luckysunz/sportstracker_plus/gehaeuse/Pictogramme/RocknRoll.webp

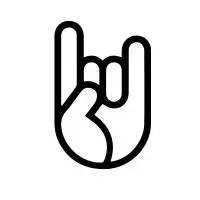
gehaeuse/Pictogramme/RocknRoll.webp
