luckysunz/sportstracker_plus/gehaeuse/Pictogramme/toilet.webp

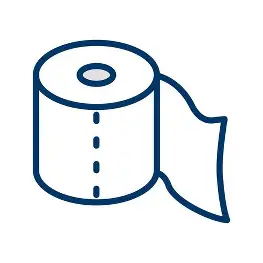
gehaeuse/Pictogramme/toilet.webp
