luckysunz/sportstracker_plus/gehaeuse/uebersicht.png

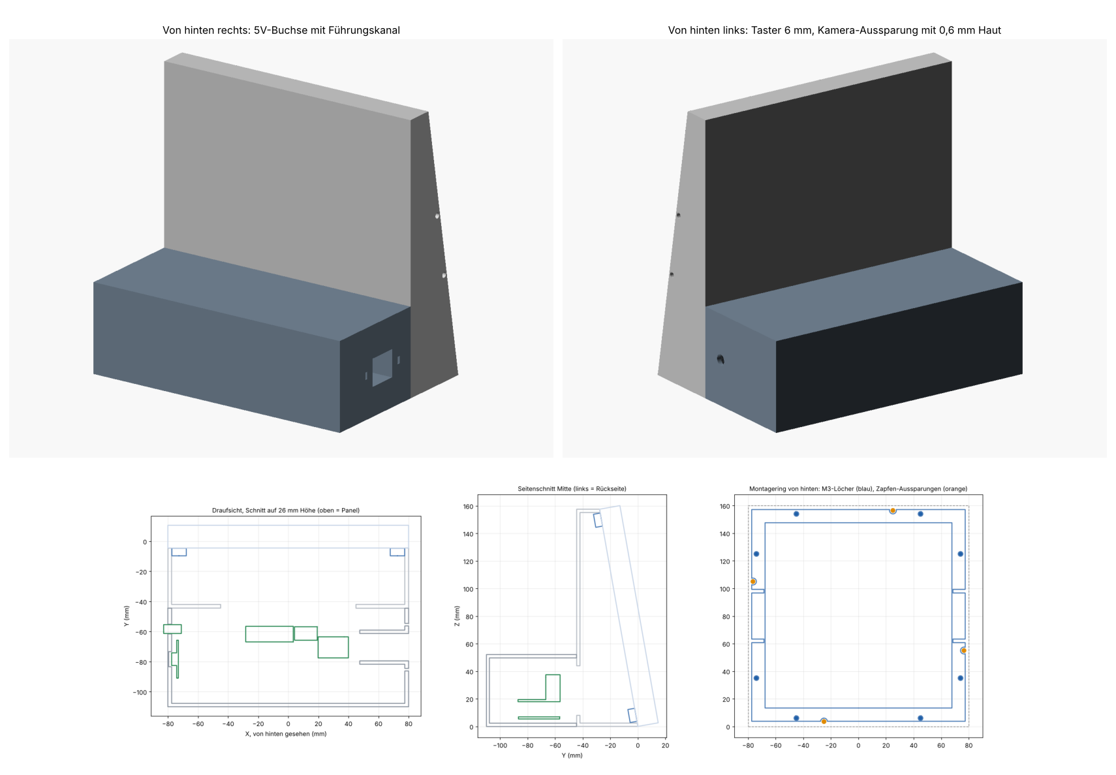
gehaeuse/uebersicht.png
