luckysunz/sportstracker_plus/gehaeuse/v2/uebersicht_v2.png

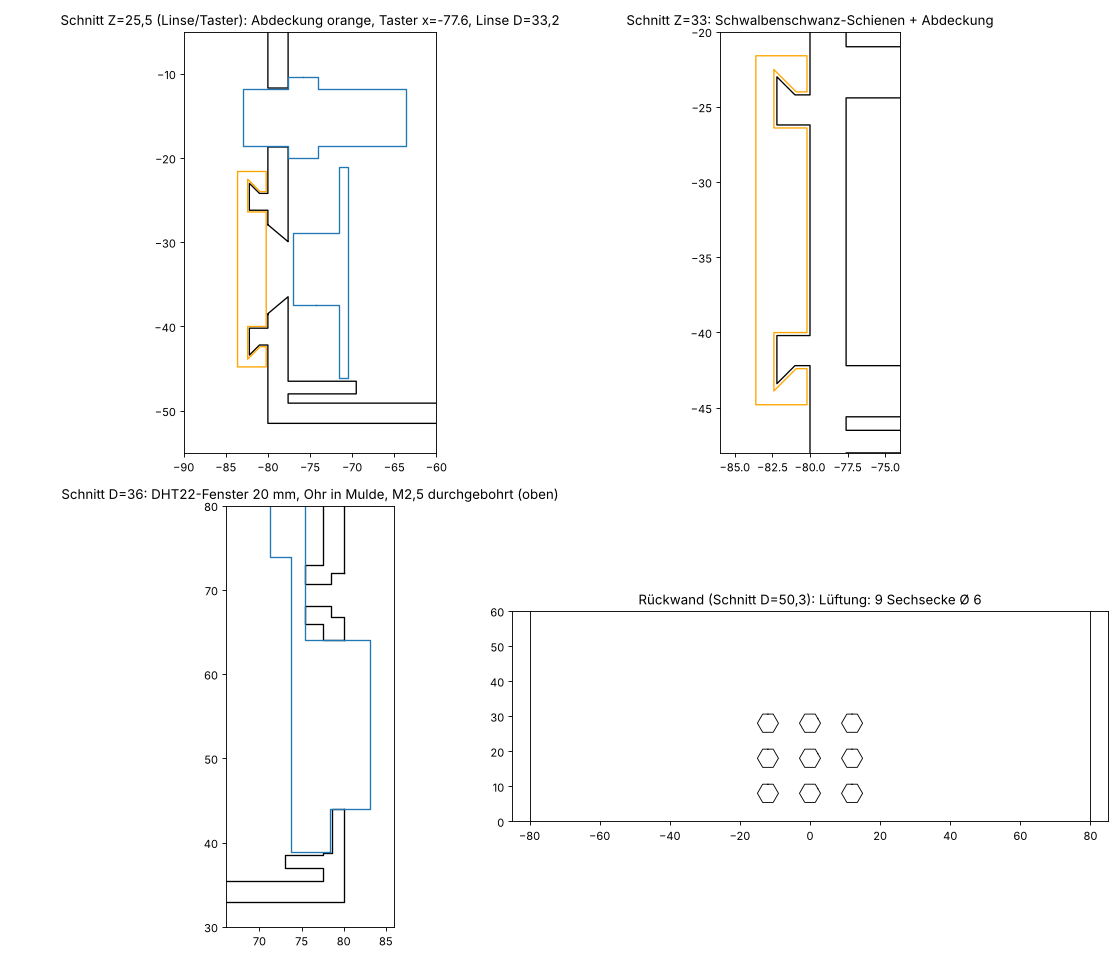
gehaeuse/v2/uebersicht_v2.png
