luckysunz/sportstracker_plus/sportstracker/demo.png

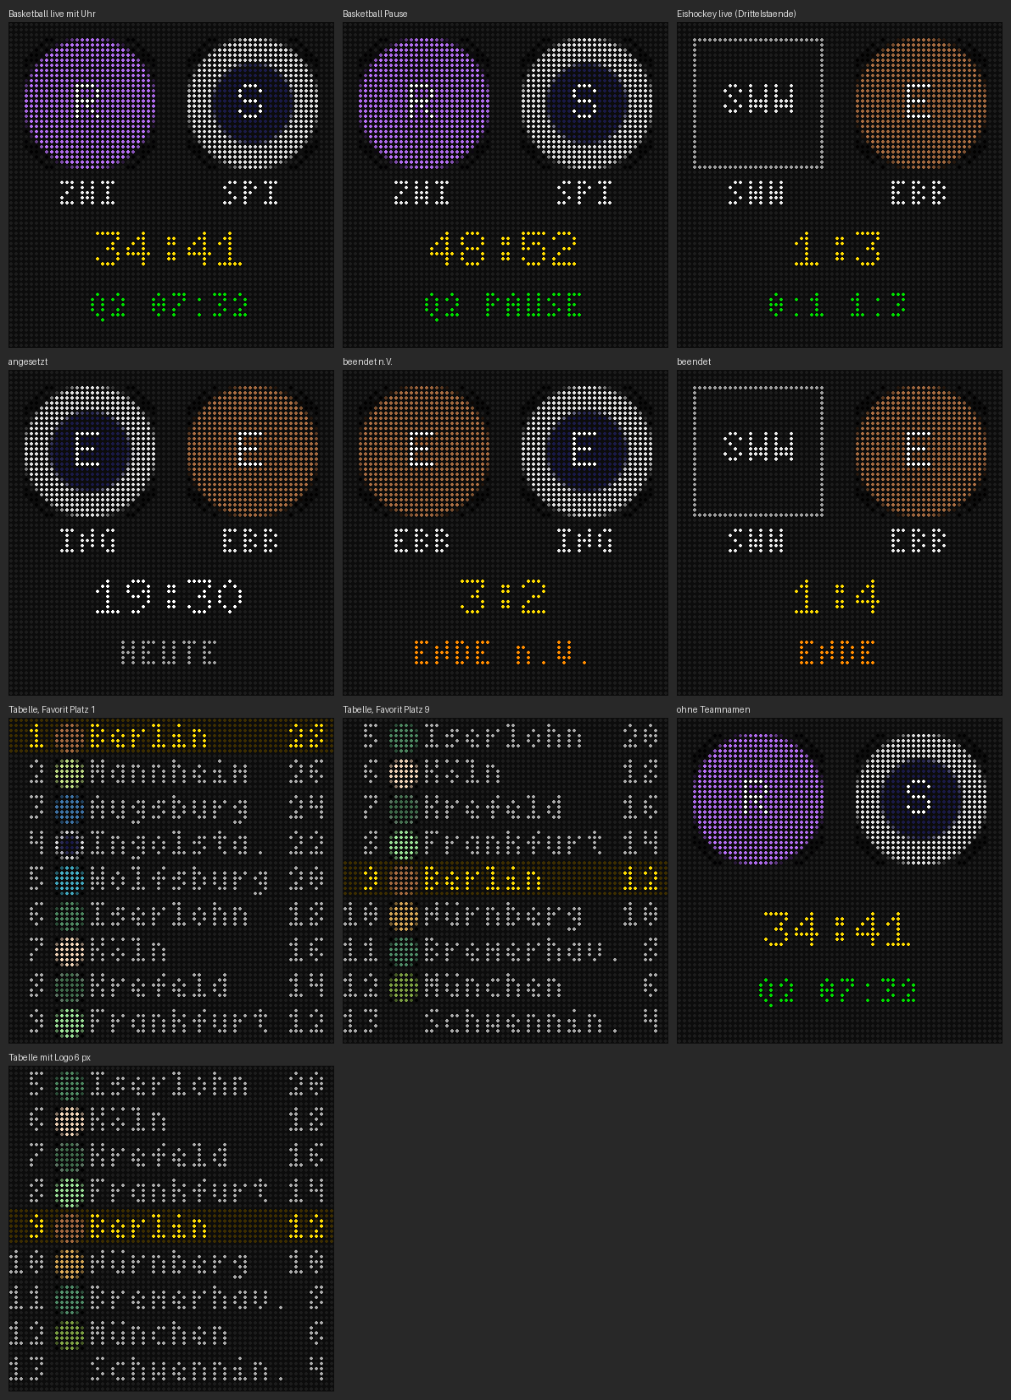
sportstracker/demo.png
