luckysunz/sportstracker_plus/sportstracker/demo_preview.png

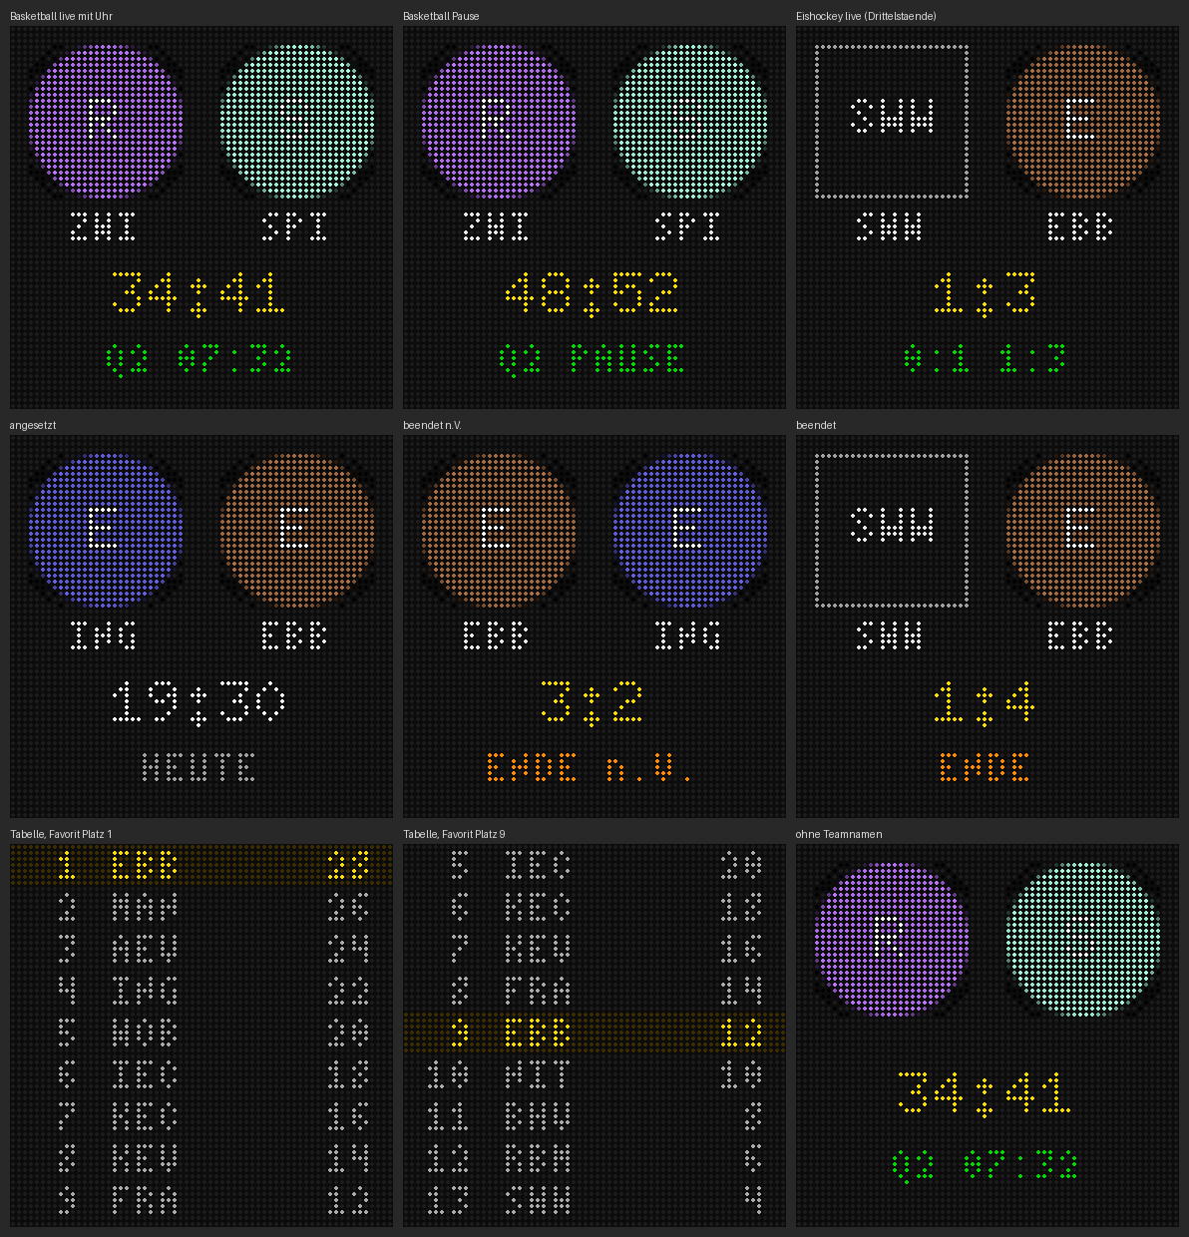
sportstracker/demo_preview.png
