luckysunz/sportstracker_plus/sportstracker/vorschau-0.7.0-designs.png

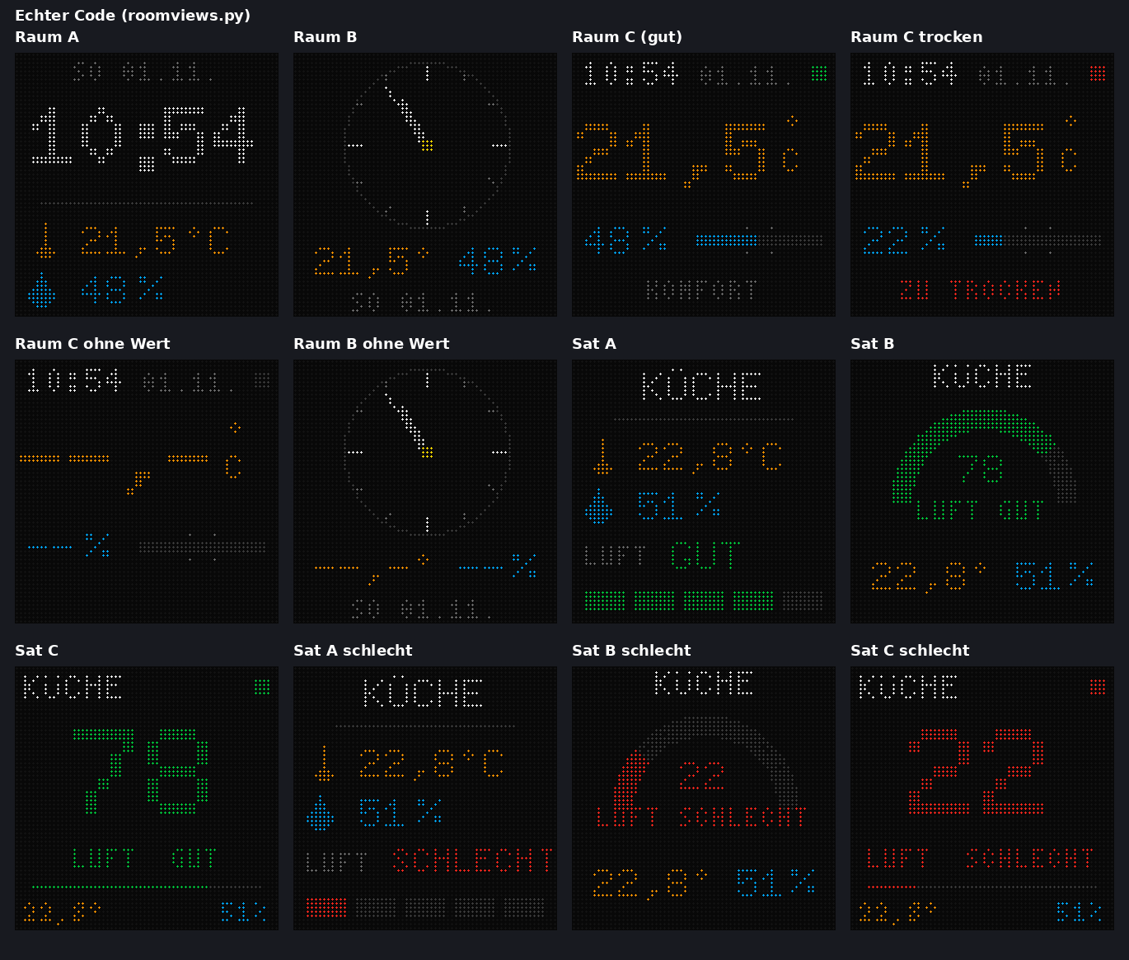
sportstracker/vorschau-0.7.0-designs.png
