luckysunz/sportstracker_plus/sportstracker/vorschau-bild-0.5.5.png

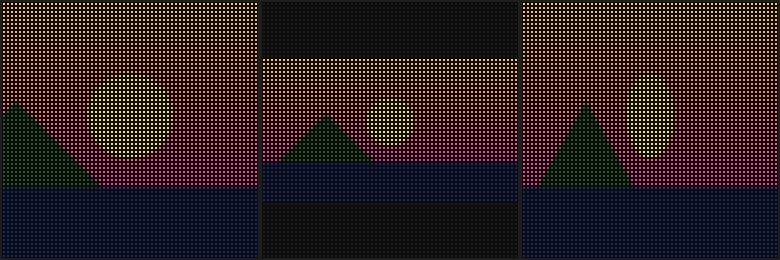
sportstracker/vorschau-bild-0.5.5.png
