luckysunz/sportstracker_plus/sportstracker/vorschau-nachricht-0.5.3.png

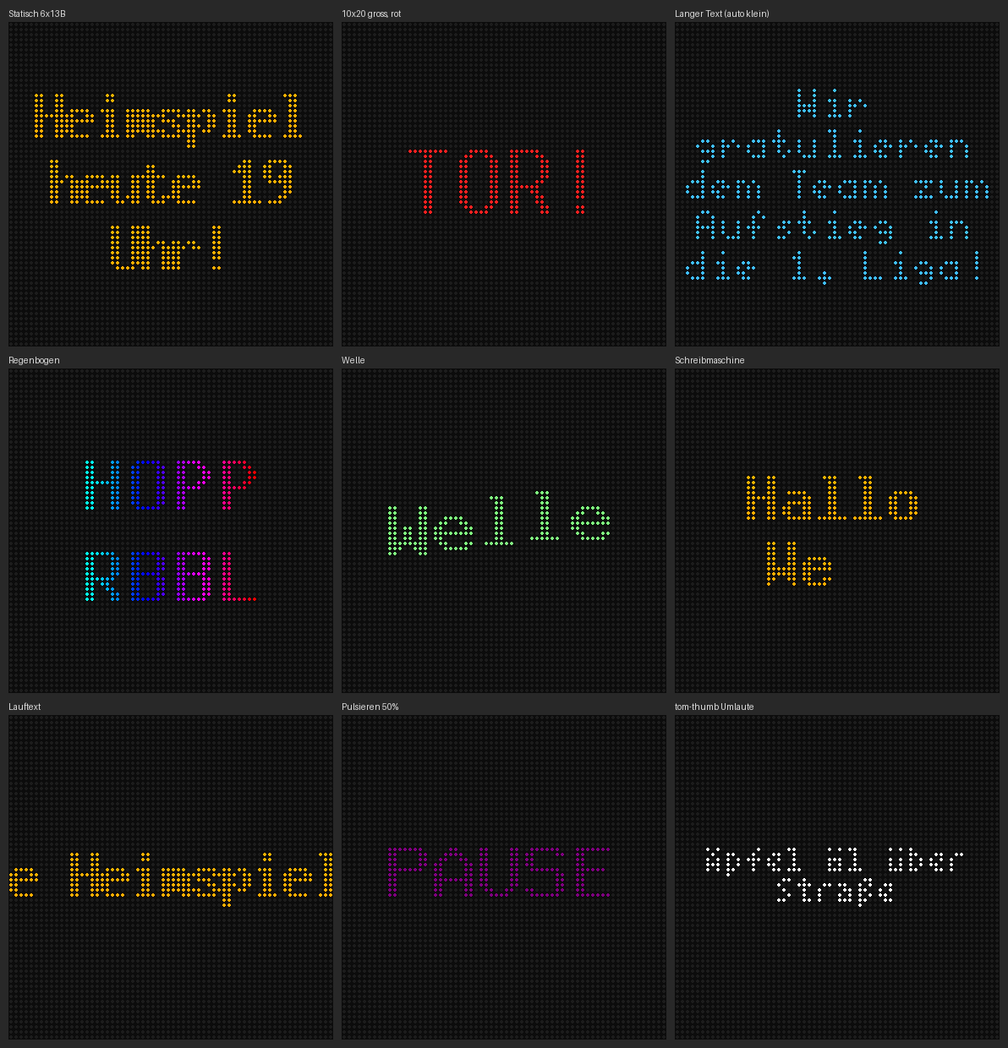
sportstracker/vorschau-nachricht-0.5.3.png
