luckysunz/sportstracker_plus/sportstracker/vorschau-raumansicht-0.5.0.png

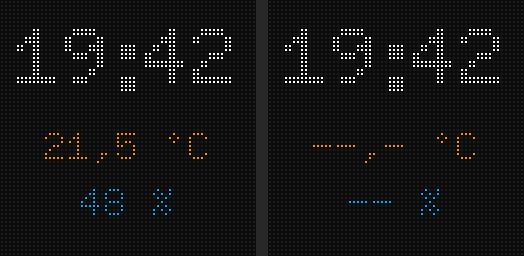
sportstracker/vorschau-raumansicht-0.5.0.png
