luckysunz/sportstracker_plus/gehaeuse/01_montagering.stl

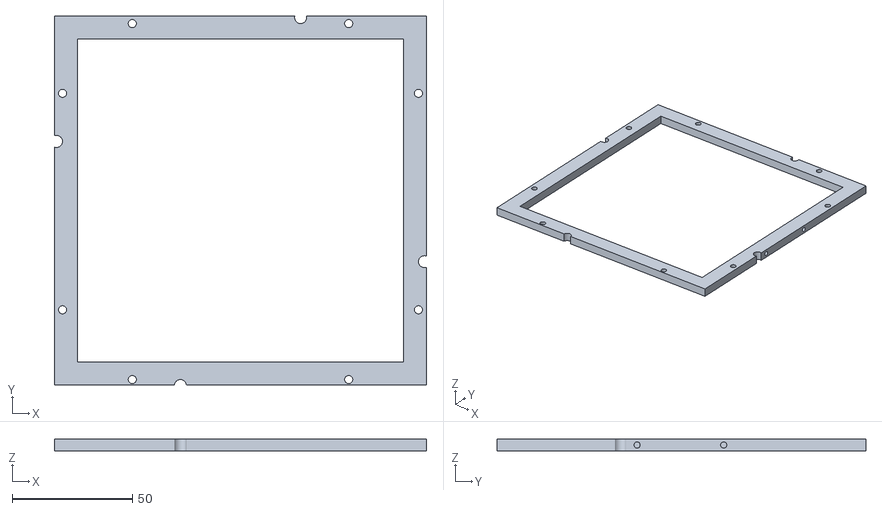
[picture p11: CAD file, 2026-11-01]
gehaeuse/01_montagering.stl
154.8 x 153.4 x 5.00
