luckysunz/sportstracker_plus/gehaeuse/Pictogramme/STL/beerpic.stl

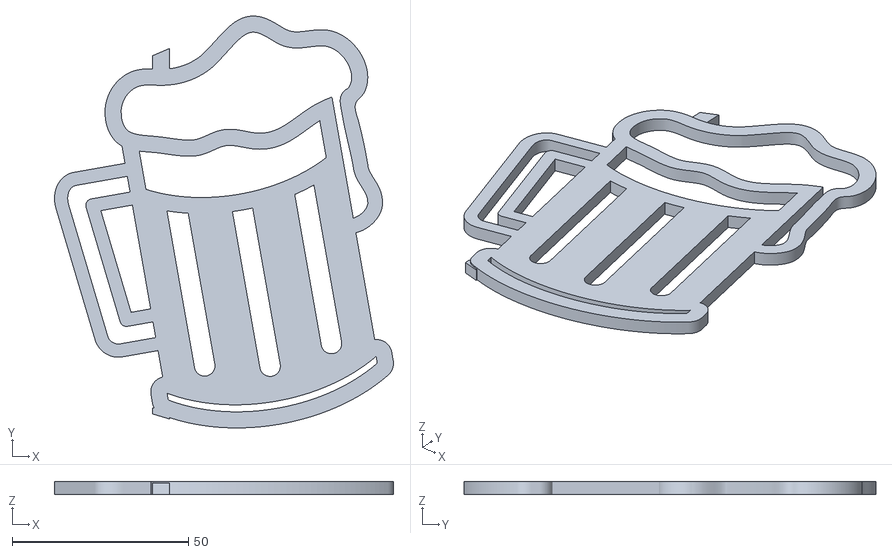
[picture p12: CAD file, 2026-11-01]
gehaeuse/Pictogramme/STL/beerpic.stl
96.3 x 117.0 x 3.60
