luckysunz/sportstracker_plus/gehaeuse/v2/05_kamera_abdeckung.stl

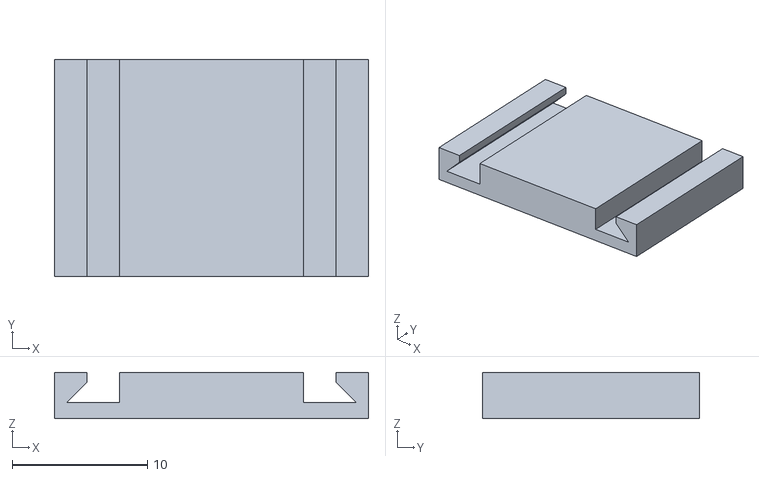
[picture p13: CAD file, 2026-11-01]
gehaeuse/v2/05_kamera_abdeckung.stl
23.2 x 16.0 x 3.40
