luckysunz/sportstracker_plus/gehaeuse/02_keilgehaeuse.stl

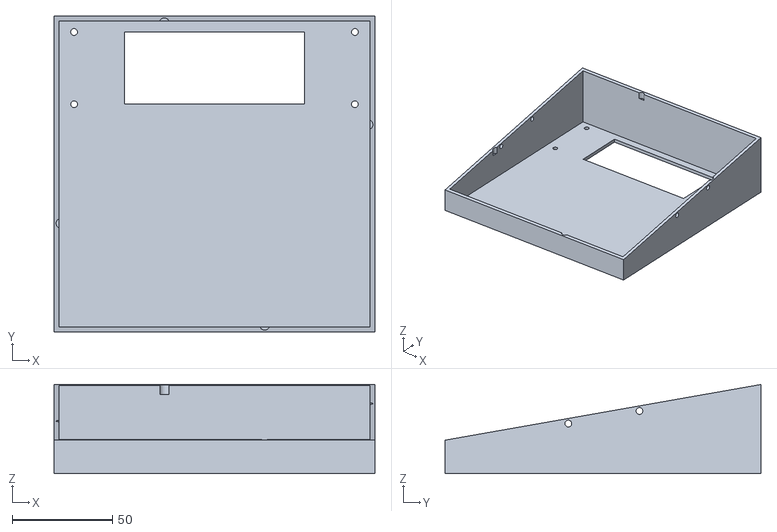
[picture p14: CAD file, 2026-11-01]
gehaeuse/02_keilgehaeuse.stl
160.0 x 157.6 x 44.4
