luckysunz/sportstracker_plus/gehaeuse/Pictogramme/STL/ImageToStl.com_toilet.stl

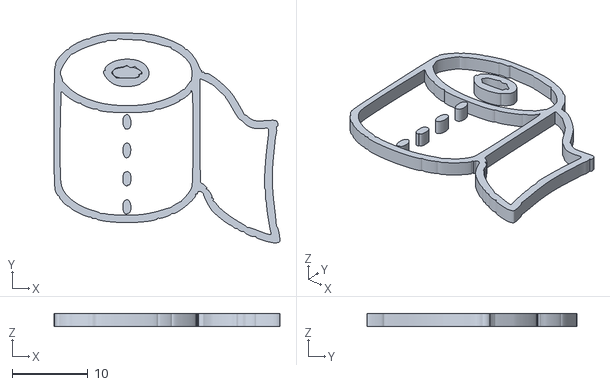
[picture p15: CAD file, 2026-11-01]
gehaeuse/Pictogramme/STL/ImageToStl.com_toilet.stl
29.9 x 27.8 x 1.65
