luckysunz/sportstracker_plus/gehaeuse/v2/03_kamera_taster_probestueck.stl

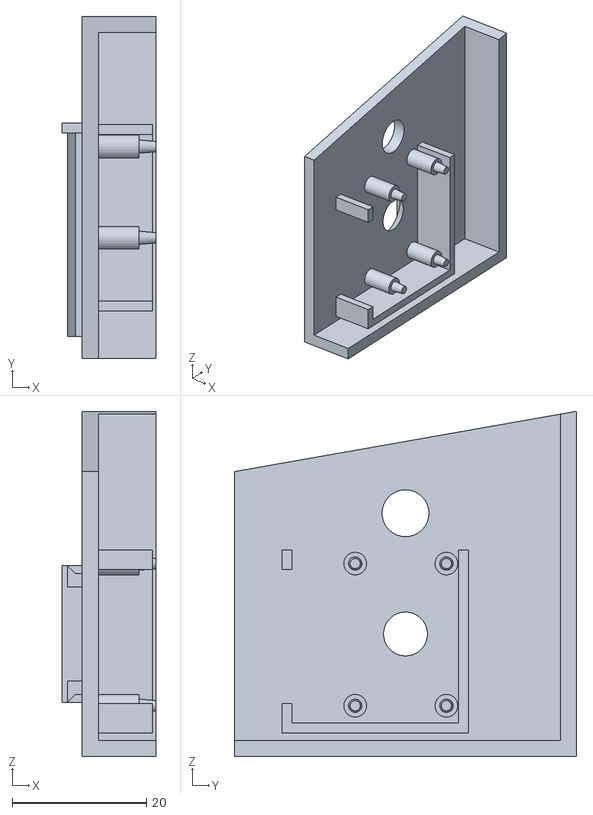
[picture p16: CAD file, 2026-11-01]
gehaeuse/v2/03_kamera_taster_probestueck.stl
14.0 x 51.0 x 51.5
