luckysunz/sportstracker_plus/gehaeuse/03_fuss.stl

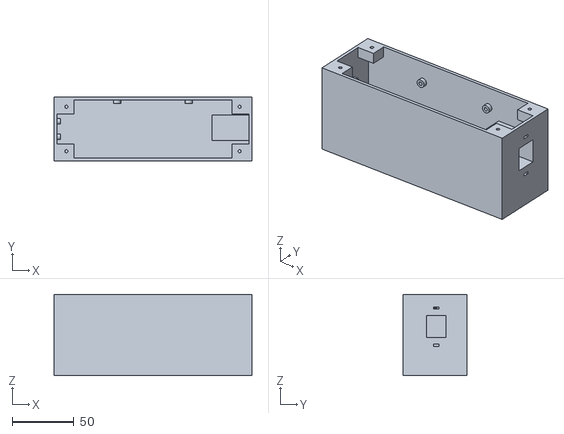
[picture p17: CAD file, 2026-11-01]
gehaeuse/03_fuss.stl
160.0 x 52.0 x 65.6
