luckysunz/sportstracker_plus/gehaeuse/Pictogramme/STL/RocknRoll.stl

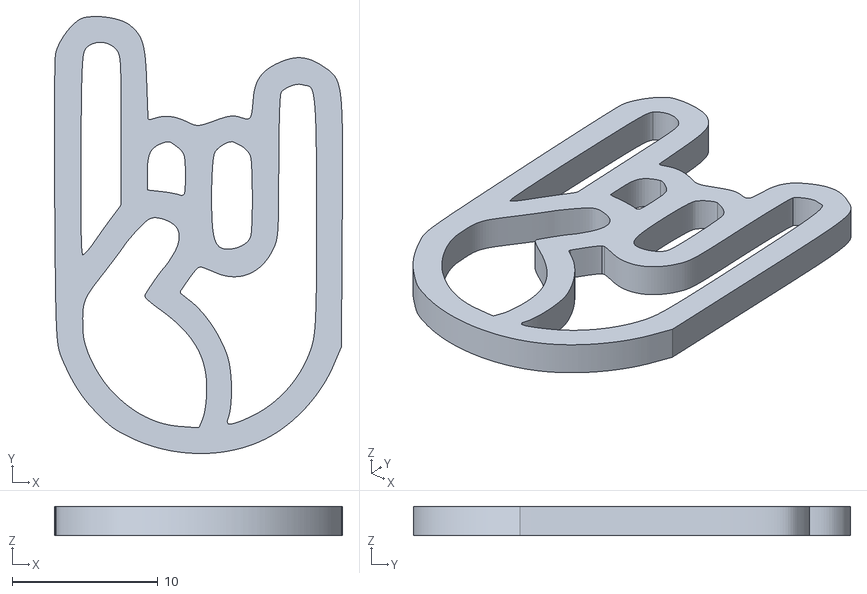
[picture p18: CAD file, 2026-11-01]
gehaeuse/Pictogramme/STL/RocknRoll.stl
19.7 x 30.0 x 2.00
