luckysunz/sportstracker_plus/gehaeuse/v2/02_keilgehaeuse_v2.stl

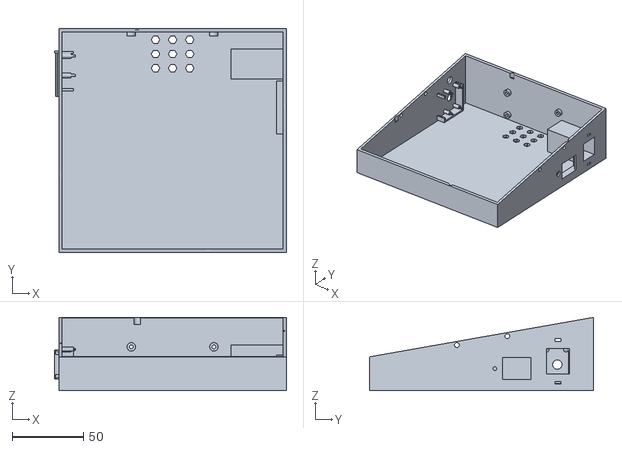
[picture p19: CAD file, 2026-11-01]
gehaeuse/v2/02_keilgehaeuse_v2.stl
163.0 x 157.6 x 51.5
