luckysunz/sportstracker_plus/gehaeuse/Pictogramme/STL/flame.stl

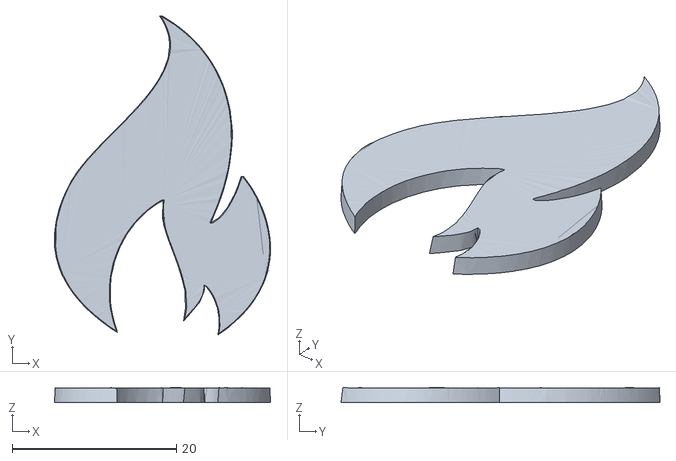
[picture p20: CAD file, 2026-11-01]
gehaeuse/Pictogramme/STL/flame.stl
26.4 x 38.9 x 1.85
