luckysunz/sportstracker_plus/gehaeuse/Pictogramme/STL/ImageToStl.com_drum-set-vector-icon.stl

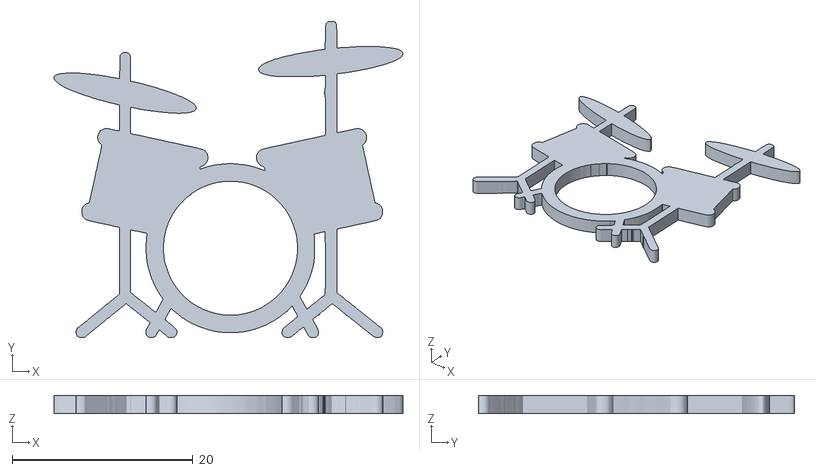
[picture p21: CAD file, 2026-11-01]
gehaeuse/Pictogramme/STL/ImageToStl.com_drum-set-vector-icon.stl
38.6 x 35.0 x 2.00
