luckysunz/sportstracker_plus/gehaeuse/v2/04_dht22_probestueck.stl

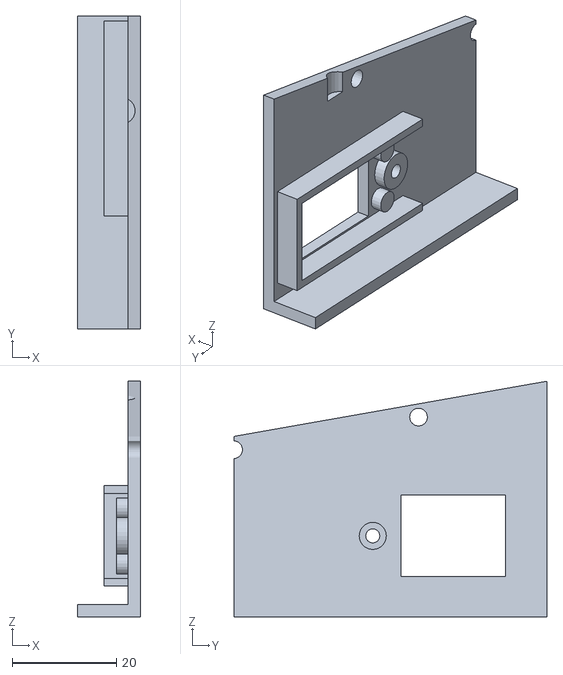
[picture p22: CAD file, 2026-11-01]
gehaeuse/v2/04_dht22_probestueck.stl
12.0 x 60.0 x 45.2
