luckysunz/sportstracker_plus/gehaeuse/Pictogramme/STL/boobs.stl

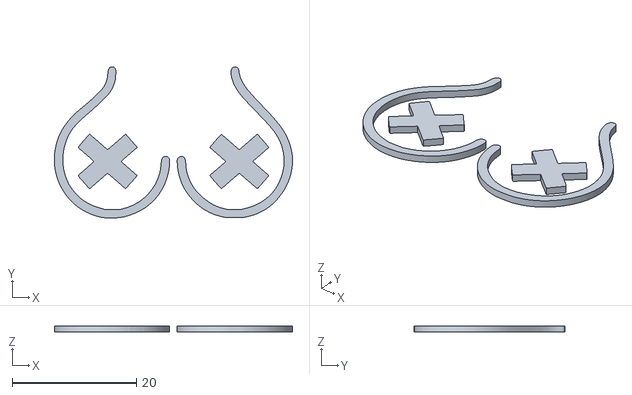
[picture p23: CAD file, 2026-11-01]
gehaeuse/Pictogramme/STL/boobs.stl
38.3 x 24.3 x 1.00
