luckysunz/sportstracker_plus/sportstracker/vorschau-0.7.0-wlan-setup.png

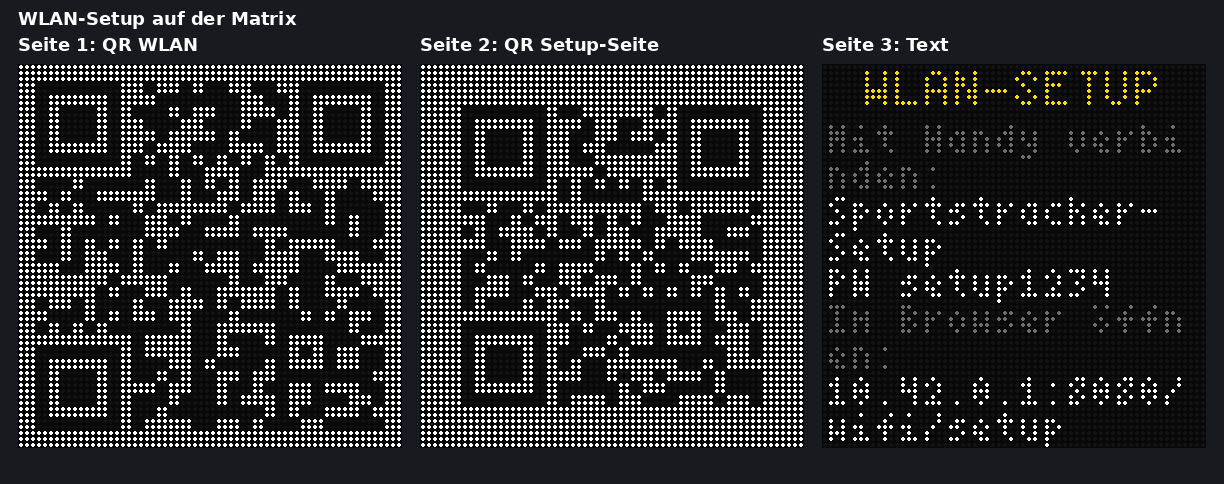
sportstracker/vorschau-0.7.0-wlan-setup.png
