luckysunz/sportstracker_plus/sportstracker/tests/fixtures/openligadb/README.txt

Fixtures: structure and values taken from api.openligadb.de responses observed on 2026-10-27
(teams.json, match_last_finished.json = match 84396, match_next_scheduled.json = match 84406).
table.json: rank-1..5 values as observed; teamInfoId assumed equal to teamId from teams.json.
Live / overtime / shootout cases are built synthetically inside the tests.
