luckysunz/sportstracker_plus/sportstracker/tests/test_genius_rbbl.py

from __future__ import annotations

import unittest
from datetime import datetime, timezone
from zoneinfo import ZoneInfo

from sportstracker.errors import HttpError, ProviderError
from sportstracker.models import GameStatus
from sportstracker.providers import create_provider
from sportstracker.providers import genius_rbbl as g
from sportstracker.providers.genius_rbbl import GeniusRbblProvider, parse_widget_time

from genius_markup import match_html, schedule_payload, standings_payload
from helpers import FakeHttp

BERLIN = ZoneInfo("Europe/Berlin")
BASE = "https://hosted.dcd.shared.geniussports.com"
SCHED = BASE + "/embednf/WHBA/en/competition/49807/schedule"
STAND = BASE + "/embednf/WHBA/en/competition/49807/standings"
LIVE = BASE + "/ldata/basketball/competitions/comp49807.json"

MUENSTER, LAHN, RHINOS, ZWICKAU, KOELN, TRIER = "36911", "36370", "36369", "36365", "36368", "36366"


def berlin(month, day, hour=12, minute=0):
    return datetime(2026, month, day, hour, minute, tzinfo=BERLIN)


def default_matches():
    return [
        # real: finished game on 17.10.
        match_html("2897422", "STATUS_COMPLETE", "Oct 17, 2026, 5:00 PM", MUENSTER, LAHN, 62, 65),
        # real: scheduled game on 31.10.
        match_html("2897434", "STATUS_SCHEDULED", "Oct 31, 2026, 5:00 PM", MUENSTER, RHINOS),
        # synthetic pairings with Zwickau
        match_html("2897440", "STATUS_SCHEDULED", "Oct 31, 2026, 5:00 PM", ZWICKAU, KOELN),
        match_html("2897441", "STATUS_POSTPONED", "Nov 7, 2026, 5:00 PM", TRIER, ZWICKAU),
    ]


def make_provider(extra_routes=None, matches=None, live_ids="", **kwargs):
    routes = {
        SCHED: schedule_payload(matches if matches is not None else default_matches(), live_ids),
        STAND: standings_payload(),
    }
    routes.update(extra_routes or {})
    http = FakeHttp(routes)
    return GeniusRbblProvider(http, 49807, BERLIN, **kwargs), http


class TimeParsingTests(unittest.TestCase):
    def parse(self, text):
        return parse_widget_time(text, BERLIN)

    def test_summer_time(self):
        self.assertEqual(self.parse("Oct 17, 2026, 5:00 PM"), datetime(2026, 10, 17, 15, 0, tzinfo=timezone.utc))

    def test_winter_time(self):
        self.assertEqual(self.parse("Oct 31, 2026, 5:00 PM"), datetime(2026, 10, 31, 16, 0, tzinfo=timezone.utc))

    def test_half_hour(self):
        self.assertEqual(self.parse("Oct 23, 2026, 7:30 PM"), datetime(2026, 10, 23, 17, 30, tzinfo=timezone.utc))

    def test_noon_and_midnight(self):
        self.assertEqual(self.parse("Nov 7, 2026, 12:30 PM").astimezone(BERLIN).hour, 12)
        self.assertEqual(self.parse("Nov 7, 2026, 12:15 AM").astimezone(BERLIN).hour, 0)

    def test_24h_without_marker(self):
        self.assertEqual(self.parse("Nov 7, 2026, 17:00").astimezone(BERLIN).hour, 17)

    def test_invalid(self):
        for bad in ("", "tomorrow", "Foo 17, 2026, 5:00 PM"):
            with self.assertRaises(ValueError):
                self.parse(bad)


class HelperTests(unittest.TestCase):
    def test_clock_format(self):
        self.assertEqual(g._format_clock("07:32:00"), "07:32")
        self.assertEqual(g._format_clock("07:32:41"), "07:32:41")
        self.assertIsNone(g._format_clock("00:00:00"))
        self.assertIsNone(g._format_clock(None))
        self.assertEqual(g._format_clock("garbled"), "garbled")

    def test_period_label(self):
        self.assertEqual(g._period_label(3, "REGULAR"), "Q3")
        self.assertEqual(g._period_label(1, "EXTRATIME"), "OT")
        self.assertEqual(g._period_label(2, "EXTRATIME"), "OT2")
        self.assertEqual(g._period_label(1, "PENALTYSHOOTOUT"), "SO")
        self.assertIsNone(g._period_label(None, "REGULAR"))

    def test_live_scores_shapes(self):
        self.assertEqual(g._live_scores({"1": 10, "2": 8}), (10, 8))
        self.assertEqual(g._live_scores({1: 10, 2: 8}), (10, 8))
        self.assertEqual(g._live_scores([None, 10, 8]), (10, 8))
        self.assertEqual(g._live_scores([10, 8]), (10, 8))
        self.assertIsNone(g._live_scores("x"))
        self.assertIsNone(g._live_scores({"1": "a", "2": 1}))


class TableTests(unittest.TestCase):
    def test_table(self):
        provider, _ = make_provider()
        rows = provider.get_table()
        self.assertEqual(len(rows), 8)
        first = rows[0]
        self.assertEqual((first.rank, first.team.team_id, first.team.name), (1, "36362", "RSB Thuringia Bulls"))
        self.assertEqual((first.played, first.won, first.lost, first.points, first.goal_diff), (2, 2, 0, 4, 89))
        self.assertTrue(first.team.logo_url.endswith("5eb2722a1622f0782cb42c94091b252fT1.png"))
        zwickau = [r for r in rows if r.team.team_id == ZWICKAU][0]
        self.assertEqual((zwickau.rank, zwickau.lost, zwickau.goal_diff), (7, 1, -16))
        self.assertEqual(rows[5].played, 0)  # Koeln without games

    def test_list_teams(self):
        provider, _ = make_provider()
        teams = provider.list_teams()
        self.assertEqual(len(teams), 8)
        self.assertIn("RB Zwickau e.V.", [t.name for t in teams])

    def test_empty_standings_is_error(self):
        provider, _ = make_provider({STAND: {"css": [], "js": [], "html": "<div>nothing</div>"}})
        with self.assertRaises(ProviderError):
            provider.get_table()


class GameOfDayTests(unittest.TestCase):
    def test_scheduled_today_for_home_and_away_team(self):
        provider, _ = make_provider()
        for team_id in (ZWICKAU, KOELN):
            game = provider.get_game_of_day(team_id, berlin(10, 31, 9))
            self.assertIsNotNone(game, team_id)
            self.assertEqual(game.game_id, "2897440")
            self.assertEqual(game.status, GameStatus.SCHEDULED)
            self.assertEqual((game.home.name, game.away.name), ("RB Zwickau e.V.", "RBC Köln 99ers"))
            self.assertEqual(game.start, datetime(2026, 10, 31, 16, 0, tzinfo=timezone.utc))
            self.assertIsNone(game.home_score)
            self.assertTrue(game.home.logo_url.startswith("https://images.statsengine"))

    def test_no_game_today(self):
        provider, _ = make_provider()
        self.assertIsNone(provider.get_game_of_day(ZWICKAU, berlin(10, 27)))

    def test_finished_game_stays_until_midnight(self):
        provider, _ = make_provider()
        game = provider.get_game_of_day(MUENSTER, berlin(10, 17, 23, 59))
        self.assertEqual(game.status, GameStatus.FINISHED)
        self.assertEqual((game.home_score, game.away_score), (62, 65))
        self.assertEqual((game.home.name, game.away.name), ("Spinto Münsterland", "RSV Lahn-Dill"))
        self.assertIsNone(provider.get_game_of_day(MUENSTER, berlin(10, 18, 0, 0)))

    def test_postponed_game_is_not_game_of_day(self):
        provider, _ = make_provider()
        self.assertIsNone(provider.get_game_of_day(ZWICKAU, berlin(11, 7)))

    def test_schedule_is_cached_between_calls(self):
        provider, http = make_provider(schedule_ttl=900)
        provider.get_game_of_day(ZWICKAU, berlin(10, 31, 9, 0))
        provider.get_game_of_day(ZWICKAU, berlin(10, 31, 9, 5))
        self.assertEqual(http.calls.count(SCHED), 1)
        provider.get_game_of_day(ZWICKAU, berlin(10, 31, 9, 20))  # > 15 min later
        self.assertEqual(http.calls.count(SCHED), 2)

    def test_static_live_status(self):
        matches = [match_html("2897440", "STATUS_IN_PROGRESS", "Oct 31, 2026, 5:00 PM", ZWICKAU, KOELN, 4, 2)]
        provider, _ = make_provider(matches=matches)
        game = provider.get_game_of_day(ZWICKAU, berlin(10, 31, 17, 10))
        self.assertEqual(game.status, GameStatus.LIVE)
        self.assertEqual((game.home_score, game.away_score), (4, 2))

    def test_live_ids_mark_game_live(self):
        provider, _ = make_provider(live_ids="2897440,2897999")
        game = provider.get_game_of_day(ZWICKAU, berlin(10, 31, 17, 10))
        self.assertEqual(game.status, GameStatus.LIVE)


class LiveOverlayTests(unittest.TestCase):
    NOW = berlin(10, 31, 17, 20)

    def live_provider(self, entry):
        return make_provider({LIVE: {"2897440": entry}})

    def test_in_progress(self):
        provider, _ = self.live_provider(
            {"clock": "07:32:00", "status": "INPROGRESS", "period": 2, "periodType": "REGULAR", "scores": {"1": 18, "2": 15}}
        )
        game = provider.get_game_of_day(ZWICKAU, self.NOW)
        self.assertEqual(game.status, GameStatus.LIVE)
        self.assertEqual((game.home_score, game.away_score), (18, 15))
        self.assertEqual(game.period_label, "Q2")
        self.assertEqual(game.clock, "07:32")
        self.assertFalse(game.period_break)

    def test_period_break(self):
        provider, _ = self.live_provider(
            {"clock": "00:00:00", "status": "PERIODBREAK", "period": 2, "periodType": "REGULAR", "scores": [None, 30, 28]}
        )
        game = provider.get_game_of_day(ZWICKAU, self.NOW)
        self.assertEqual(game.status, GameStatus.LIVE)
        self.assertTrue(game.period_break)
        self.assertIsNone(game.clock)
        self.assertEqual(game.period_label, "Q2")
        self.assertEqual((game.home_score, game.away_score), (30, 28))

    def test_extra_time(self):
        provider, _ = self.live_provider(
            {"clock": "02:10:00", "status": "INPROGRESS", "period": 1, "periodType": "EXTRATIME", "scores": {"1": 60, "2": 60}}
        )
        self.assertEqual(provider.get_game_of_day(ZWICKAU, self.NOW).period_label, "OT")

    def test_complete_overrides_stale_schedule(self):
        provider, _ = self.live_provider(
            {"clock": "00:00:00", "status": "COMPLETE", "period": 4, "periodType": "REGULAR", "scores": {"1": 71, "2": 66}}
        )
        game = provider.get_game_of_day(ZWICKAU, berlin(10, 31, 19, 30))
        self.assertEqual(game.status, GameStatus.FINISHED)
        self.assertEqual((game.home_score, game.away_score), (71, 66))
        self.assertIsNone(game.clock)

    def test_not_requested_long_before_tip_off(self):
        provider, http = self.live_provider({"status": "INPROGRESS"})
        provider.get_game_of_day(ZWICKAU, berlin(10, 31, 9, 0))
        self.assertNotIn(LIVE, http.calls)

    def test_live_feed_failure_is_not_fatal(self):
        provider, _ = make_provider({LIVE: HttpError("boom")})
        game = provider.get_game_of_day(ZWICKAU, self.NOW)
        self.assertEqual(game.status, GameStatus.SCHEDULED)

    def test_unknown_match_in_live_feed_is_ignored(self):
        provider, _ = make_provider({LIVE: {"1": {"status": "INPROGRESS"}}})
        self.assertEqual(provider.get_game_of_day(ZWICKAU, self.NOW).status, GameStatus.SCHEDULED)

    def test_garbage_live_feed_is_ignored(self):
        provider, _ = make_provider({LIVE: ["not", "a", "dict"]})
        self.assertEqual(provider.get_game_of_day(ZWICKAU, self.NOW).status, GameStatus.SCHEDULED)
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
