luckysunz/sportstracker_plus/sportstracker/tests/test_openligadb.py

from __future__ import annotations

import copy
import unittest
from datetime import datetime, timedelta, timezone
from zoneinfo import ZoneInfo

from sportstracker.errors import HttpError, ProviderError
from sportstracker.models import GameStatus
from sportstracker.providers.openligadb import OpenLigaDbProvider

from helpers import FakeHttp, load_fixture

BERLIN = ZoneInfo("Europe/Berlin")
BASE = "https://api.openligadb.de"
EBB = "641"  # Eisbaeren Berlin
LAST_URL = BASE + "/getlastmatchbyleagueteam/4947/641"
NEXT_URL = BASE + "/getnextmatchbyleagueteam/4947/641"


def berlin(year, month, day, hour=12, minute=0):
    return datetime(year, month, day, hour, minute, tzinfo=BERLIN)


def make_provider(routes):
    http = FakeHttp(routes)
    provider = OpenLigaDbProvider(http, "del", 2026, 4947, BERLIN)
    return provider, http


def synthetic_match(match_id, start_utc, results, finished, home=641, away=338):
    """Match in the OpenLigaDB shape; variants for live/overtime cases."""
    base = copy.deepcopy(load_fixture("openligadb", "match_next_scheduled.json"))
    teams = {t["teamId"]: t for t in load_fixture("openligadb", "teams.json")}
    base["matchID"] = match_id
    base["matchDateTimeUTC"] = start_utc
    base["matchDateTime"] = start_utc.replace("Z", "")
    base["team1"] = teams[home]
    base["team2"] = teams[away]
    base["matchIsFinished"] = finished
    base["matchResults"] = [
        {
            "resultID": 0,
            "resultName": name,
            "pointsTeam1": h,
            "pointsTeam2": a,
            "resultOrderID": order,
            "resultTypeID": type_id,
            "resultTypeKind": kind,
            "resultDescription": "",
        }
        for order, (name, h, a, type_id, kind) in enumerate(results, start=1)
    ]
    return base
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
