luckysunz/sportstracker_plus/(commit log)

2026-11-01 Initial commit: Sportstracker+ 0.6.2
    [01_montagering.stl, 02_keilgehaeuse.stl, 02_keilgehaeuse_v2.stl, 03_fuss.stl, 03_kamera_taster_probestueck.stl, 04_dht22_probestueck.stl, 05_kamera_abdeckung.stl, ImageToStl.com_drum-set-vector-icon.stl]
2026-11-01 Bild-Upload: HEIC/AVIF-Hinweis, MPO und abgeschnittene Uploads
